TechNovation01/nRF24Doctor/README.md

# nRF24Doctor
nRF24 Doctor for MySensors

To compile on windows, run mklink.bat to create symbolic links to shared files.
