TechNovation01/nRF24Doctor/(threads)

Thread 7 (2018-05-10):

Menu sidebar disappears in rare cases

TechNovation01, 2018-05-10:
The menu (right) sidebar can disappear in some cases.
A reproducible case is as follows:

- Go into "Settings" menu
- Press Button to change "Payload value"
- Press Button to accept new "Payload value"
- Turn encoder knob in the direction upward in the menu

Now the sidebar has disappeared and re-appears when you turn the encoder knob in the downward menu direction. It appears to be related to a top menu item (which can be changed) only.

Yveaux, 2018-09-01:
Failed to reproduce with LCDMenuLib2 v1.2.7(May 13, 2018)

TechNovation01, 2018-09-01:
Indeed appears to be resolved, no longer reproducible with LCDMenuLib2 v1.2.7(May 13, 2018).

Closed 2018-09-01.

Thread 21 (2019-09-16):

BOM List

dvdcut, 2019-09-16:
Hi,
these are more as question rather then issue but feel free to delete if does not suite here.
Can you add BOM list for this project please, its very interesting work but its hard for nob like me to replicate this.

TP_GND2 TP_GND are normal GND but what is the purpose of these two?
TP_Current isn't going anywhere as well.
TP_AREF and TP_TRIG have some special needs for some external hardware/connection?

LD117AV33 is option and only required if powering it from batter and supply power through to nrf radio?

Thread 22 (2020-06-26):

PCB KiCAD (or Gerber?) files?

TRSx80, 2020-06-26:
I could not even open the PDFs to have a look at them, but that could very likely be on my end because I block all kinds of scripts, frames, etc. by default so perhaps I could not allow the right combination of crap from GitHub through in order to render the PDF.  Which is fine by me.  Maybe I try again later to simply clone repo at command line and then see if I can look at the PDF locally.

Anyway, on to my actual point...  :smile:

Would you guys consider releasing KiCAD or gerber or whatever files you may have, so I could maybe get this board made at some board house somewhere (I am thinking OshPark might be ideal)?

Or even better, maybe putting it on OpenHardware.io?
