TechNovation01/nRF24Doctor/pcb/nRFDoctor_1.1_brd.pdf

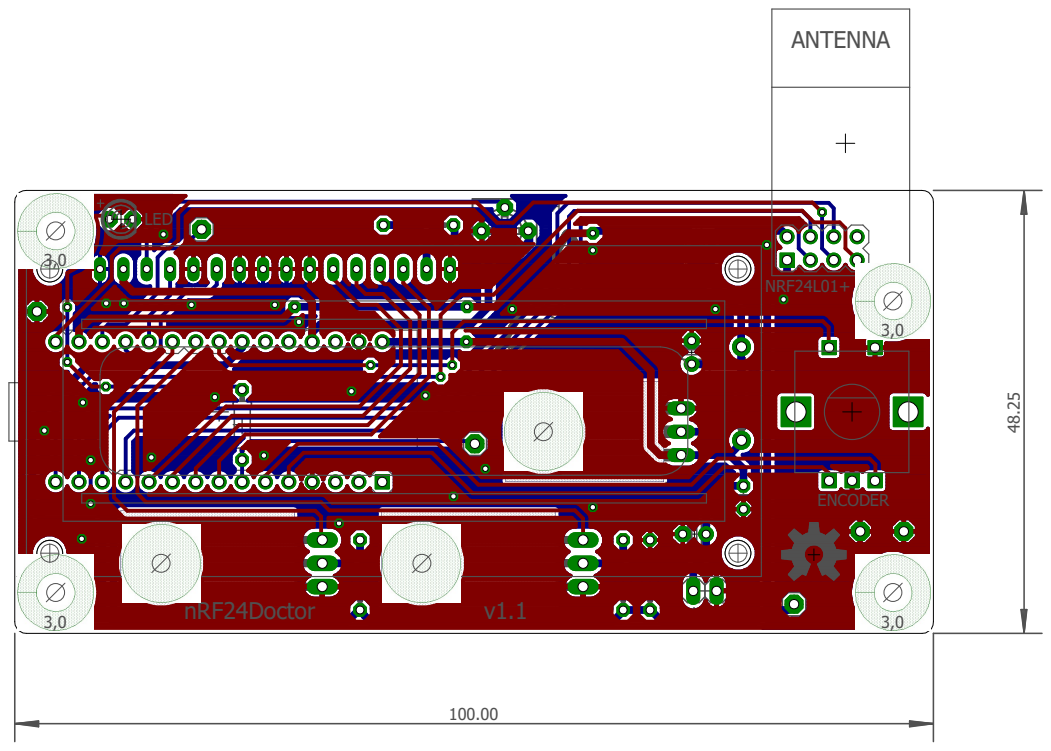
[picture p1: page 1]
nRF24Doctor; ENCODER; NRF24L01+; LED
