TechNovation01/nRF24Doctor/pcb/nRFDoctor_1.1_brd_top.pdf

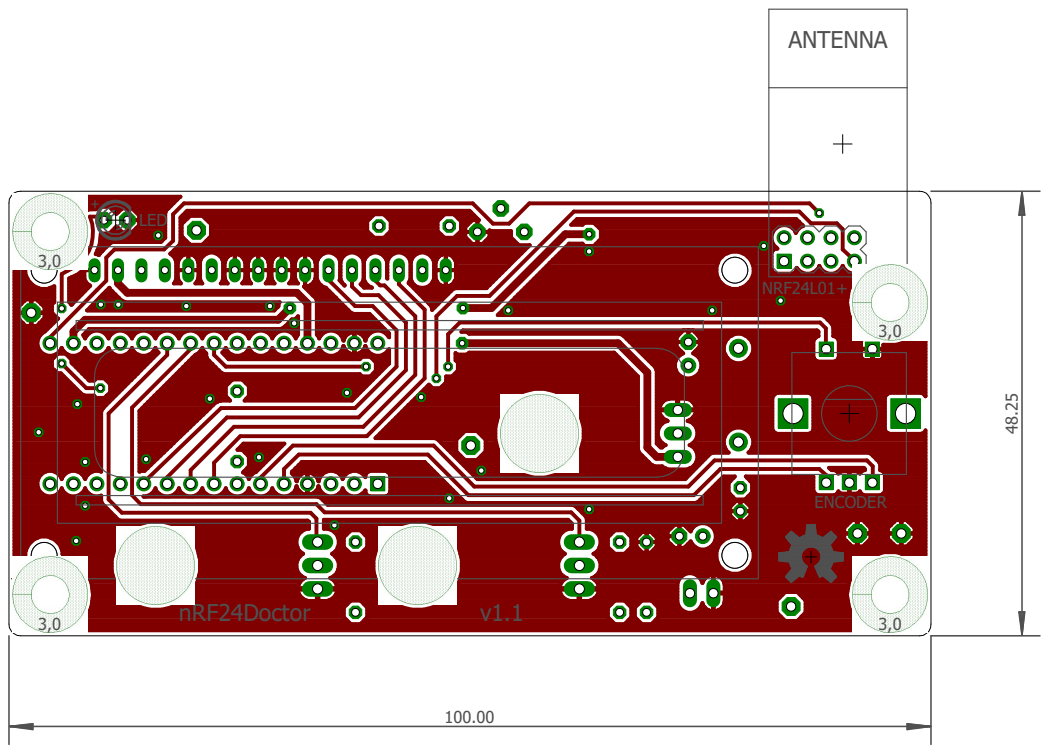
[picture p2: page 1]
ANTENNA; nRF24Doctor; ENCODER; NRF24L01+; LED
