TechNovation01/nRF24Doctor/pcb/nRFDoctor_1.1_sch.pdf

# GND VCC

# GND VCC

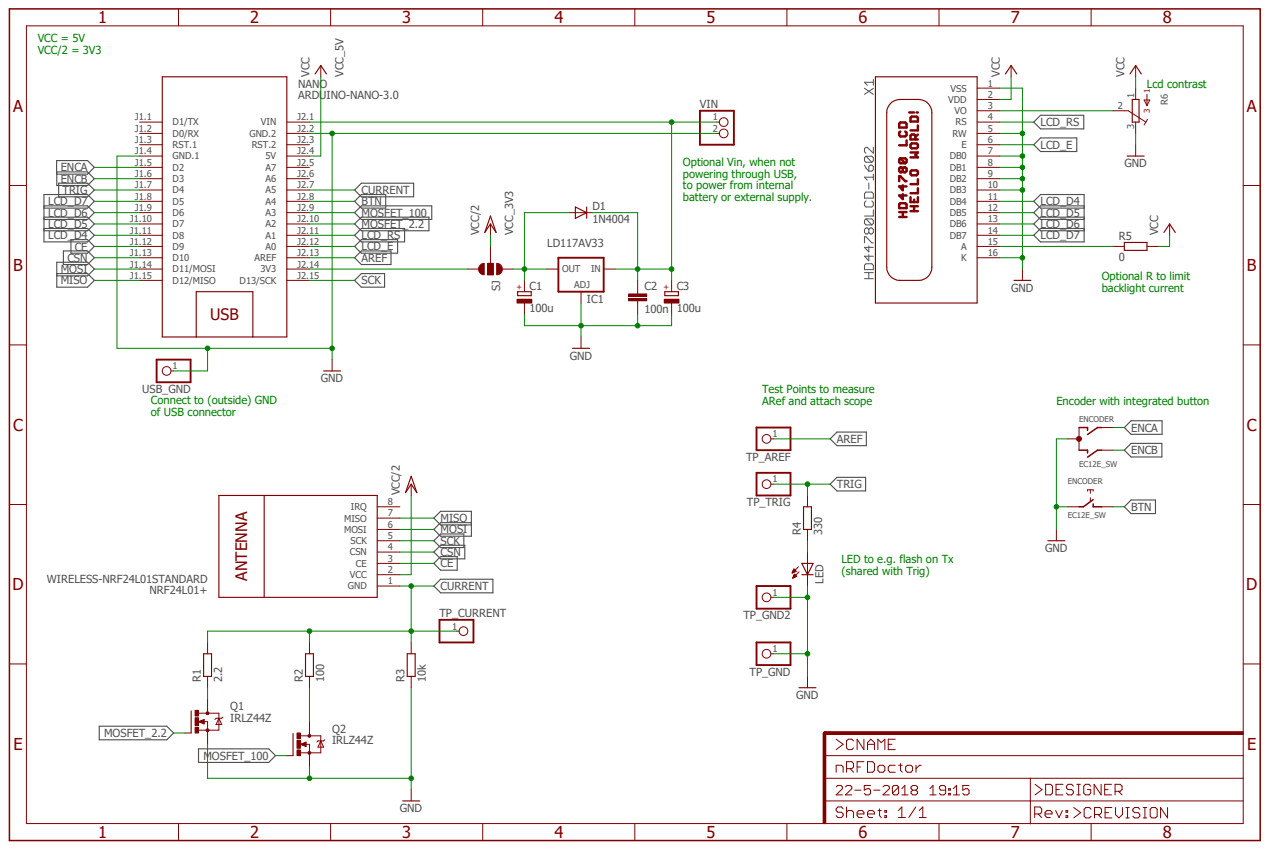
[picture p3: page 1]

Optional Vin, when not
powering through USB,
to power from internal
battery or external supply.

USB_GND
Connect to (outside) GND
of USB connector

Test Points to measure
ARef and attach scope

Encoder with integrated button

LED to e.g. flash on Tx
(shared with Trig)
