TechNovation01/nRF24Doctor/pcb/nRFDoctor_1.1_brd_bot.pdf

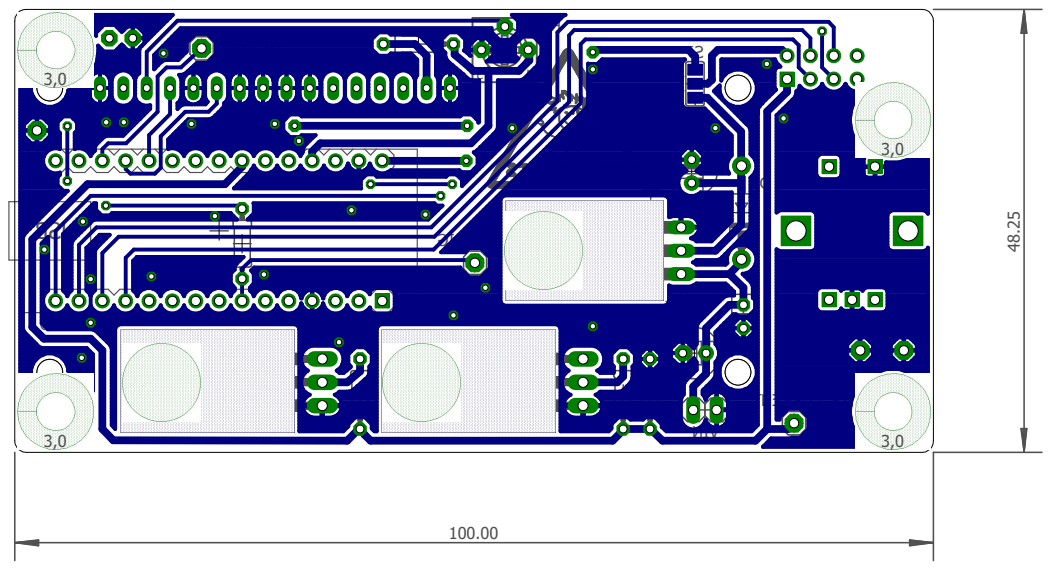
[picture p4: page 1]
