TechNovation01/nRF24Doctor/(commit log)

2018-04-15 Fixed Folder structure
    Folder structure fixed to work with Arduino IDE
    [nRF24DoctorGateway.ino, nRF24DoctorNode.ino]
2018-04-17 Updated Current Measurements
    Includes measurement of TX&RX currents
2018-04-18 TX/RX Current Measurement fix
    TX/RX Current measurement fix when the radio has been unable to connect to the gateway.
    [nRF24DoctorNode.ino]
2018-04-28 Make resistor values config items
    Allow for easy calibration
2018-04-28 Use LcdMenuLib2 & encoder
    Switched to using LcdMenuLib2, Encoder and Bounce2 for button.
    Configuration not yet implemented.
2018-04-29 Reworked eeprom handling
    Loading eeprom settings will revert to defaults if contents are invalid.
    Eeprom magic number changed from 0xFF, as that is the default for an
    empty eeprom.
    Implemented menu item to revert to defaults.
    [nRF24DoctorNode.ino]
2018-05-01 Fix encoder value to button conversion
    [nRF24DoctorNode.ino]
2018-05-01 Start GW update on request
    Added separate eeprom menu entries for node & node+gw
    Always reset node after saving eeprom to activate new settings.
    [nRF24DoctorNode.ino]
2018-05-01 From INT to PCINT
    Changed Pin Interrupt trigger for current measurement to a Pin Change Interrupt. This is directly linked to the CE-Pin and frees up a interrupt for the encoder.
2018-05-01 Cleanup INTERRUPT
    remove obsolete interrupt remainders
2018-05-03 INT pins for Encoder
    Re-arranged pins to get both INT pins available for the encoder to improve response
2018-05-10 Dynamic Time Scaling Tx Current Measurement
    Scale the Tx Current Measurement period according to the size of the set Transmission Payload
2018-05-22 Bug fix - break @ wrong line
    Bug fix - break @ wrong line...
    [nRF24DoctorNode.ino]
2018-05-25 Statemachine Update & RX current fix
    - Simplified the statemachine
    - Fixed Message Rate inaccuracies
    - Removed time constraint of RX current in statemachine
    - Fixed RX current measurement by forcing it into RX mode manually before the measurement (now also measures the current correctly if the node can not find the gateway @ startup)
    [nRF24DoctorNode.ino]
2018-05-25 Fixed "Failed" Gateway update message
    [nRF24DoctorNode.ino]
2018-07-20 Pcb support (#12)
    * Removed TFT display support
    Cleanup, as PCB version only supports 16x2 LCD
    * Reversed encoder direction
    Feels more natural when CW moves down in menus
    * Reverted encoder direction
    Feels weird when having to turn CCW to increase valuies in menus.
    * Add LED to indicate TX success
    LED is lit on send, switched off on success. Failre to TX keeps the LED
    on.
    Very basic implementation; can be made more advanced later on.
    * Added PCB schematics & layout v1.1
    [nRF24DoctorNode.ino]
2018-07-21 Detect & display critical errors
    [nRF24DoctorNode.ino]
2018-07-21 Improve error handling
    Display 'search gateway' when transport is not ready and detect hardware errors.
    [nRF24DoctorNode.ino]
2018-07-26 Share config storage between node & gw
    Created new shared/nRF24DoctorShared.h that contains code shared between node and gateway.
    It mainly focuses on eeprom storage, retrieval and radio configuration.
    The file is shared by both sketches by creating symbolic links to the same file (yes, this is Arduino ide...)
    Before building on Windows run mklink.bat to create these symbolic links.
    Reconfiguring a running MySensors stack is no longer required as the configuration is stored in parameters which are read from eeprom before the stack starts.
    Any configuration updates will be stored in eeprom, followed by a reset (both node & gw).
    Gateway now also stores its configuration in eeprom, so after r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
    [nRF24DoctorGateway.ino, nRF24DoctorNode.ino]
2018-07-26 Reduce screen update rate
    10Hz was too much; reduced to 5Hz
    [nRF24DoctorNode.ino]
2018-07-26 Remove BaseID support
    BaseID is defined on compile time in MySensors, and changing it at runtime didn't run stable.
    There is no real requirement to support BaseID, but default BaseID has been set different compared to default in MySensors stack to allow coexistence of gateways.
    Move radio configuration (and the variables it uses during stack configuration) to a separate file.
    [RadioConfig.h, nRF24DoctorGateway.ino, nRF24DoctorNode.ino]
2018-07-27 Reworked setting menu
    Split in radio settings (which become effective after eeprom save) and doctor settings (which become effective immediately).
    Removed load node eeprom menu, as it was confusing (some parameters became effective immediately, some not).
    Added Reset node option.
    [nRF24DoctorNode.ino]
2018-07-31 Refactored printBufCurrent
    Separated errors from value conversion.
    Reduced code size of value conversion.
    [nRF24DoctorNode.ino]
2018-08-26 Channel Scanning Implementation (& Fix Child ID & SetSensor)
    Implemented Channel Scanning by mostly using the exisiting functions. Note that as a consequence for each change in channel the system stores the new channel number in eeprom and reboots the device.
    Fixed Child ID numbers and removed the SetSensor line
    [nRF24DoctorGateway.ino, nRF24DoctorNode.ino]
2018-09-01 Add Received Power Detection scanner (#17)
    * Basic RPD Channel Scanner
    Dumps data to serial output.
    * Statemachine cleanup
    * Add missing statemachine part
    * Basic LCD graph display
    * Add indicator and channel display
    * Fixes to pointer display
    * Fix pointer range check
    * Display Wifi channel for pointer
    * Change pointer to small stripe
    * Fix warning
    * Reduce scan timer per channel to 1ms
    To make scanner more responsive
    * Disable serial logging of scan by default
    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
    [nRF24DoctorNode.ino]
2018-09-02 Rpd scanner fixes (#18)
    * Fix limbo state of reverting non-rpd channel scanner
    Increase node version number to 1.2
    * Revert channel from eeprom after scan
    Channel in ram might be different from channel radios are using.
    [RadioStorage.h, nRF24DoctorGateway.ino, nRF24DoctorNode.ino]
2018-09-03 Fix: Menu entry GW Node is actually Destination Node
    [CharLcdMenu.ino, nRF24DoctorNode.ino]
