TechNovation01/nRF24Doctor/(notices)

Notices in the files:
nRF24DoctorGateway/nRF24DoctorGateway.ino:
modify it under the terms of the GNU General Public License
